eminalpkoyuncu/EE463-Term-Project/figures/title.png

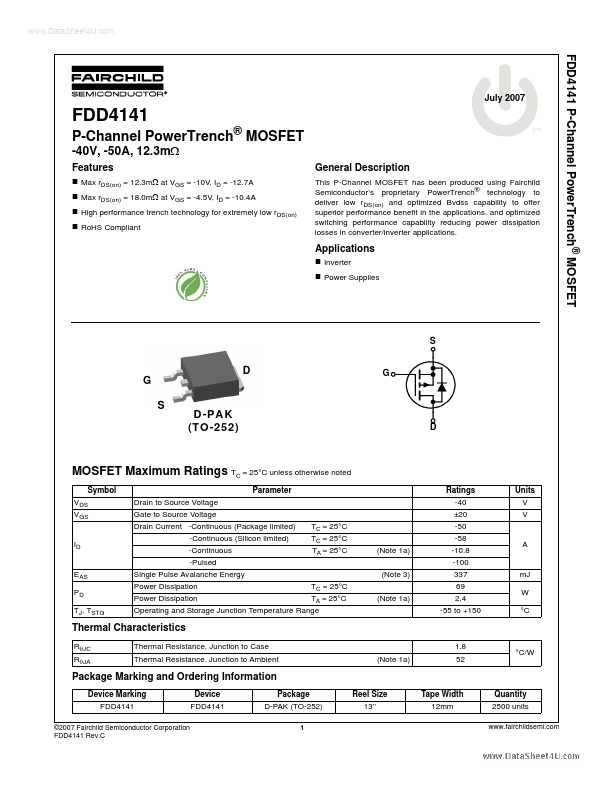
figures/title.png
