eminalpkoyuncu/EE463-Term-Project/555_timer.asc

C1: cap; 100n
R1: res; 3k
R2: res; 4k
R3: res; 1k
R4: res; 100
U1: NE555
U3: TLP2761
V1: voltage; 5
V2: voltage; 300
Named nets: 0
.tran 0 1e-2 0 1e-4 startup uic
