eminalpkoyuncu/EE463-Term-Project/rectifier_with_pmos.asc

C1: cap; 10µ
C2: cap; 100µ
C3: cap; 100p
C4: cap; 4.7µ
C5: cap; 10n
D1: diode; VS-E5TH1512
D2: diode
D3: diode
D4: diode
D5: diode
D6: diode
D7: diode
L1: ind; 1m
L2: ind; 12.5e-3
M2: pmos; IRF9640
R1: res; 0.8
R2: res; 3k
R3: res; 4k
R4: res; 1k
R5: res; 100
U1: NE555
U2: TLP2761
V1: voltage; 180
V2: voltage; 5
V3: voltage; SINE(0 160 50 0 0 0)
V4: voltage; SINE(0 160 50 0 0 -120)
V5: voltage; SINE(0 160 50 0 0 -240)
Named nets: 0, Vo, Va
,ic V(C1)= 0  V(C2)= 0  V(C3)= 0  V(C4)= 0 I(L1)=0 I(L2)=0
.tran 0 0.120 0 1e-3 startup uic
