eminalpkoyuncu/EE463-Term-Project/(commit log)

2022-12-10 3phase diode rect slx
2022-12-10 Simulation of FBR+Buck Converter
2022-12-10 FBR + Buck Converter Final Simulation
2022-12-10 ltspice simulations, simulation report final added
    simulation report final edition, ltspice simulations for 555 timer and gate driver added
2023-01-24 Arduino codes
